eelstretching/universal-strip-controller/(commit log)

2026-09-04 Added power, output, and more status LEDs
    [Output.kicad_sch, Power.kicad_sch, Status-LEDs.kicad_sch, universal-strip-controller.kicad_sch]
2026-09-07 Fix ERC: register missing libraries, add PWR_FLAGs, rename zone rails
    - Register project-local sym-lib-table/fp-lib-table. PixelBlit points at
    pico-pixel's live library; RPI_COMPILED/KiCad_Standard/EasyEDA/PCM_JLCPCB
    footprints vendored (via the abandoned universal-strip-controller-first
    attempt) into libs/; RPI_DB, RPI - Power, EasyEDA, PCM_JLCPCB-Diodes and
    PCM_JLCPCB-Resistors symbols extracted from the schematics' own embedded
    symbol cache into standalone .kicad_sym files, validated with
    `kicad-cli sym upgrade`.
    - Fix U1's footprint: RPI_COMPILED:rpi_rp2350b doesn't exist anywhere
    (not even in the original RP2350B-MINIMAL reference) - corrected to
    rpi_rp2350b_vias, the fo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
    [Output.kicad_sch, Power.kicad_sch, universal-strip-controller.kicad_sch]
2026-09-07 Updated symbols from library
    [Output.kicad_sch, Power.kicad_sch, universal-strip-controller.kicad_sch]
2026-09-07 Removed redundant labels
    [universal-strip-controller.kicad_sch]
2026-09-09 Added power sensing for each of the VIN zones
    [Power.kicad_sch, universal-strip-controller.kicad_sch]
2026-09-11 Added RM2 footprint, about to add the others
    [universal-strip-controller.kicad_pcb, universal-strip-controller.kicad_sch]
2026-09-11 Added footprints for resistors
    [Output.kicad_sch, Power.kicad_sch, Status-LEDs.kicad_sch, universal-strip-controller.kicad_sch]
2026-09-11 Updated 2m ohm resistors
    [Power.kicad_sch]
2026-09-13 Add firmware/ with task-level DS3231 and INA226 drivers
    Scaffolds a Pico C SDK project targeting this board's RP2350B with two
    from-scratch drivers, since no well-maintained native pico-sdk library
    covers either chip: usc_ds3231 (get/set time, power-loss check,
    temperature) and usc_ina226 (current/voltage/power reads calibrated from
    the actual 2 mOhm shunt in Power.kicad_sch). Both APIs are task-level
    ("what time is it", "how many amps") rather than register-level.
    Verified by building both example firmwares end-to-end against a real
    pico-sdk 2.1.1 checkout with the arm-none-eabi toolchain.
2026-09-13 Confirm real I2C/wifi pins, add WiFi NTP RTC-sync firmware, bump to SDK 2.3.0
    Traced universal-strip-controller.kicad_sch/Power.kicad_sch net-by-net
    (wires, junctions, global labels) rather than guessing at conventions:
    - DS3231 + all four INA226s share GPIO38/GPIO39 (MCU_SDA/MCU_SCL nets),
    with GPIO37 as the RTC's INT/SQW line.
    - The RM2 wifi module (CYW43439) is on GPIO40-43 (SCLK/CS/DATA/WL_ON).
    Along the way found that the schematic's MCU_SDA/MCU_SCL net names are
    swapped relative to the RP2350's silicon-fixed I2C1 SDA/SCL roles
    (confirmed from the SDK's own io_bank0.h register definitions) -- the
    examples use the hardware-correct pin roles, documented prominently in
    firmware/README.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
    [lwipopts.h, main.c, universal_strip_controller.h]
2026-09-13 Fix SDA/SCL swap and floating I2C pins in the schematic
    universal-strip-controller.kicad_sch:
    - Swapped the MCU_SDA/MCU_SCL global labels at the RP2350B's GPIO38/GPIO39
    pins, so the net names now match the RP2350's silicon-fixed I2C1 SDA/SCL
    roles (GPIO38=SDA, GPIO39=SCL) instead of the reverse. Only the two
    label instances at the MCU end needed changing -- KiCad global labels
    connect by name project-wide, so every pull-up resistor, the DS3231, and
    all four INA226s automatically picked up the corrected net.
    - Wired the DS3231's SDA (pin 15) and SCL (pin 16) pins to the MCU_SDA/
    MCU_SCL nets -- both were previously unconnected (SDA had no wire at
    all; SCL had a stray no_connect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
    [Power.kicad_sch, universal-strip-controller.kicad_sch]
2026-09-13 Wire INA226 A0/A1 to match the schematic's own documented address scheme
    Power.kicad_sch already had text annotations next to each of the four
    INA226s spelling out the intended per-channel address (0x40/0x41/0x44/
    0x45, via A1 and A0 each tied to GND or VS) -- I'd missed these entirely
    in the previous pass since I was only looking at electrical objects
    (wires/labels/pins), not schematic text notes.
    Checking the actual A0/A1 wiring against that documented plan turned up a
    real bug: channels 3 and 4 (U14, U15) need A1 tied to VS, but both had a
    no_connect flag on A1 instead (which reads as GND), so as wired they'd
    have collided with channels 1 and 2. This took three rounds of back and
    forth t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
    [Power.kicad_sch]
2026-09-13 Use 0.01 ohm breadboard shunt in power_monitor example, not the real 2 mOhm
    2 mOhm precision shunts are expensive special-order parts; 0.01 ohm is a
    reasonable stand-in for bench testing with a generic INA226 breakout.
    Lowered max_expected_amps to 5A to stay under the ~8.2A ceiling the
    INA226's fixed +-81.92mV shunt-voltage range imposes at this resistance
    (vs ~41A at the real board's 2 mOhm) -- plenty of headroom for bench
    testing, but worth knowing about before pushing a channel harder.
    [main.c]
2026-09-13 Auto-seed DS3231 from build timestamp when it has lost power
    Wiring up just the RTC (no wifi yet) previously meant rtc_time_example
    would correctly detect a dead/unset clock but then print garbage forever,
    since nothing ever set it. Seeds from this firmware's own __DATE__/__TIME__
    build timestamp instead -- not a real time source (that's wifi_rtc_sync's
    job once wifi is wired up), but enough to confirm the DS3231 wiring and
    coin-cell backup actually work before wifi is in the picture.
    [main.c]
2026-09-13 Added Waveshare Core2350 board definition for prototyping
2026-09-13 Add prototype board header for the Waveshare Core2350B breakout
    waveshare_core2350b_prototype.h composes waveshare_core2350b.h (Waveshare's
    own board definition, just checked in) with this project's I2C1 GPIO38/39
    assignment, so the same driver/example code can target either the real
    custom PCB or this bare RP2350B breakout used for bench prototyping.
    Deliberately leaves wifi undeclared for now -- no RM2 module wired up to
    this board yet, so wifi_rtc_sync should fail to build against it rather
    than fail at runtime against hardware that isn't there.
    Also fixes a real bug this surfaced: PICO_BOARD_HEADER_DIRS only tells
    CMake where to find the *selected* board file by name at configure time -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
    [waveshare_core2350b_prototype.h]
2026-09-14 Rewrite ds3231/ina226 drivers as C++ classes
    Ds3231 and Ina226 replace the C struct+free-function API with actual
    classes: construct with the I2C peripheral (and, for Ina226, address/
    shunt/current-range), call init(), then use methods directly -- no more
    threading a &rtc/&dev pointer through every call.
    Fallible reads return std::optional<T> instead of an out-param plus a
    bool, which C++17 (already this project's standard) makes free: getDatetime()
    returns std::optional<datetime_t>, Ina226::read() returns
    std::optional<Ina226::Reading>, etc.
    This is a straight port of the existing, already-validated register-level
    logic (BCD conversion, the two's-complement temperature combination, the
    ca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
    [ds3231.cpp, ds3231.hpp, main.c, main.cpp]
2026-09-23 Seems messed up?
    [universal-strip-controller.kicad_pcb]
2026-09-23 Removed power monitoring, it's too much, eh?
    [Power.kicad_sch, universal-strip-controller.kicad_sch]
2026-09-23 Fix firmware GPIO map to match the schematic netlist
    The board headers, examples and README used a hand-traced pin map that
    was off by several pins. Per KiCad's exported netlist:
    - I2C1 (MCU_SDA/MCU_SCL): GPIO42/GPIO43, not GPIO38/GPIO39
    - RTC_INT: GPIO44, not GPIO37
    - RM2: WL_ON=GPIO38, DI_DO=GPIO39, CS=GPIO40, SCLK=GPIO41
    (was WL_ON=43, DATA=42, CLOCK=40, CS=41)
    Also rewrote the README's "Confirmed pins" section, dropping the
    account of the bogus schematic "SDA/SCL swap fix", and noted that the
    INA226s have been removed from the board (driver and power_monitor
    example kept for use with an external breakout).
    Built all examples against pico-sdk 2.3.0 for PICO_BOARD=
    universal_strip_con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
    [main.cpp, universal_strip_controller.h, waveshare_core2350b_prototype.h]
2026-09-23 Remove INA226 driver and power_monitor example
    The INA226 zone power monitoring was dropped from the board design
    (ced7174), so the driver and its example have nothing to run against.
    Removed both, their CMake entries, and the README/comment references.
    Rebuilt against pico-sdk 2.3.0: rtc_time and wifi_rtc_sync build for
    universal_strip_controller; rtc_time builds for the prototype board.
2026-09-23 Remove dangling wire stubs from the schematic
    Clears all 15 unconnected_wire_endpoint ERC warnings:
    - Output.kicad_sch: deleted 11 short stubs hanging off junctions and a
    dead-end wire chain beside U11 that led to nothing.
    - universal-strip-controller.kicad_sch: trimmed the J1 SWCLK/SWD wires
    back to their labels (they overshot past them) and deleted a 0.6 mm
    stub at the DS3231's VBAT junction.
    Verified with KiCad's exported netlist: connectivity is identical
    before and after.
    [Output.kicad_sch, universal-strip-controller.kicad_sch]
2026-09-26 Start PCB layout and add mounting holes
    Footprints placed on the board, H1-H4 mounting holes added to the
    schematic, and schematic updates to Output and Power sheets.
    [Output.kicad_sch, Power.kicad_sch, universal-strip-controller.kicad_pcb, universal-strip-controller.kicad_sch]
2026-09-26 Add StatusLights driver for the SK6812 status LED chain
    StatusLights drives a chain of RGB status LEDs through PicoLEDs'
    Strip/Renderer, with the light count as a constructor argument. Each
    light shows a LightPattern (solid, blink, flicker); new behaviors are
    new LightPattern subclasses. Includes a status_lights example, the
    GPIO32 status LED pin and count in both board headers, and PicoLEDs
    wired into the build via PICOLEDS_PATH.
    Also restores PICO_BOARD to universal_strip_controller (it had been
    switched to pico2_w, which caps the SDK at 30 GPIOs) and keeps the Pico
    VS Code extension's header block and firmware .gitignore.
2026-09-26 Add debug UART1 (GPIO36/37) as the board's default UART
    Confirmed from the exported netlist: GPIO36/GPIO37 go to debug header J2
    pins 1/2, which the RP2350 fixes as UART1 TX/RX. Without a default UART
    in the board header, stdio_uart output went nowhere.
    [universal_strip_controller.h]
2026-09-27 Working on layout
    [Status-LEDs.kicad_sch, universal-strip-controller.kicad_pcb]
2026-09-28 I think the output terminals are well-arranged now. Discovered pixel-blits layout all on my own.
    [Output.kicad_sch, universal-strip-controller.kicad_pcb]
2026-09-28 Lined up the output connectors. Might actually be able to route this one
    [universal-strip-controller.kicad_pcb]
2026-10-11 Did away with the status LEDs for now, too much real estate
